nitehack/SFRNEC/Media/IMG-20140110-WA0000.jpg

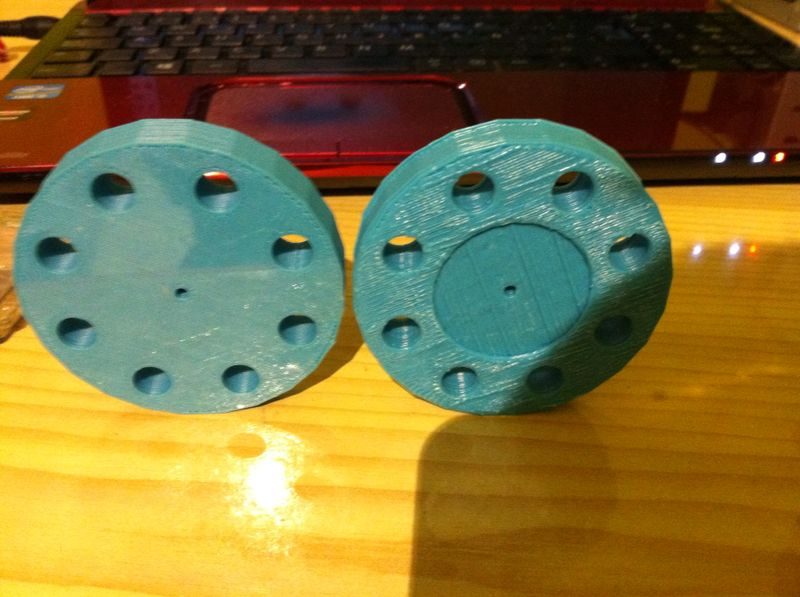
Media/IMG-20140110-WA0000.jpg
