nitehack/SFRNEC/Media/rueda libre.png

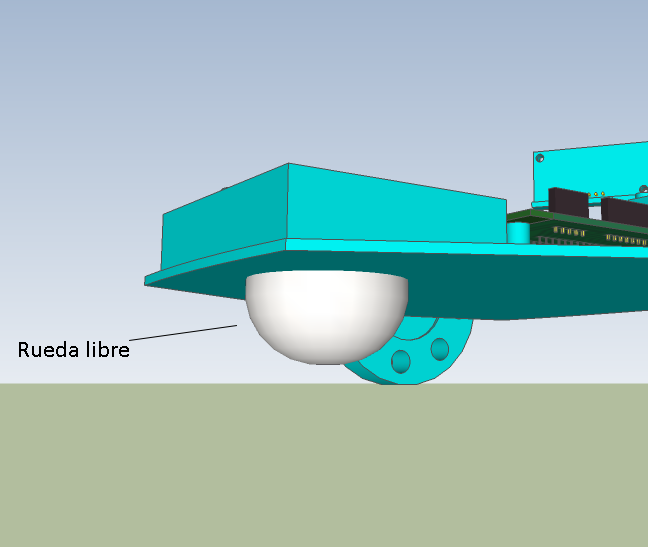
Media/rueda libre.png
