nitehack/SFRNEC/README.md

SFRNEC
======
This is a printable robot. 
It is a simple robot upgradeable. An example is included in the repository to control the robot via a IR remote control.

Authors
-------
Made for
* Víctor Burgos González
* Nicolás Guerrero García (Nitehack)
* Alejandro Toral López
* Pedro Manuel Vallejo Muñoz
