nitehack/SFRNEC/Hardware/Media/PCB 3D1.png

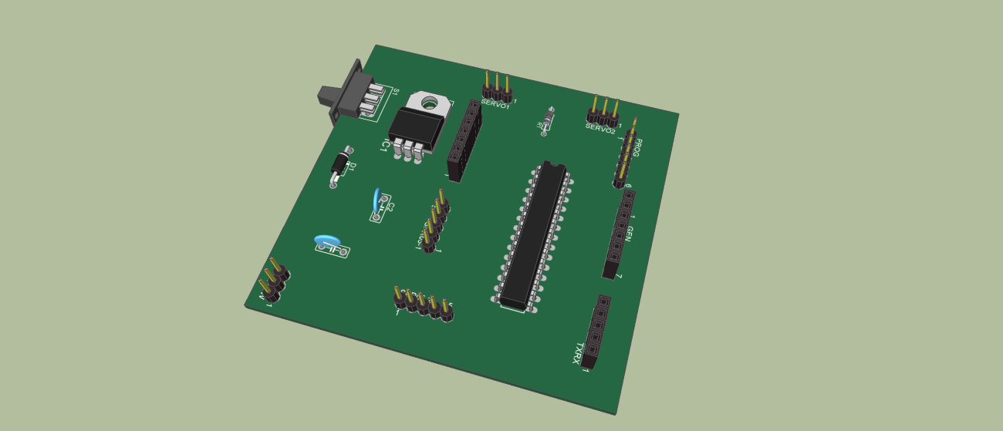
Hardware/Media/PCB 3D1.png
