nitehack/SFRNEC/Hardware/Media/PCB 3D.png

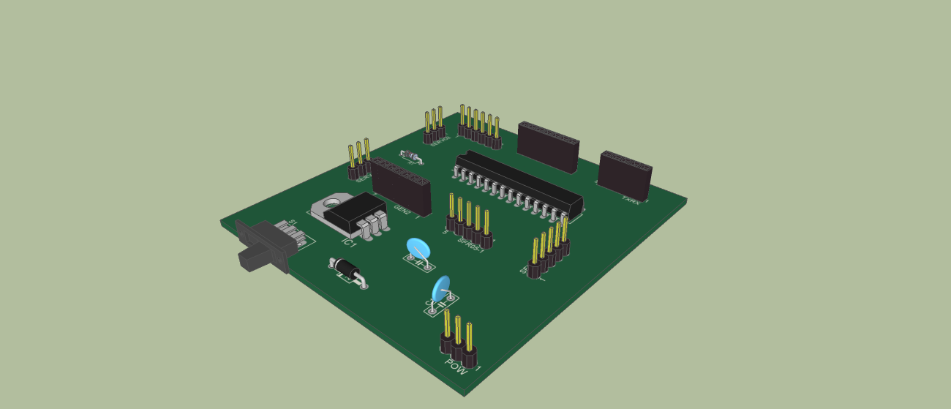
Hardware/Media/PCB 3D.png
