nitehack/SFRNEC/Hardware/PCB/pcb-bottom.png

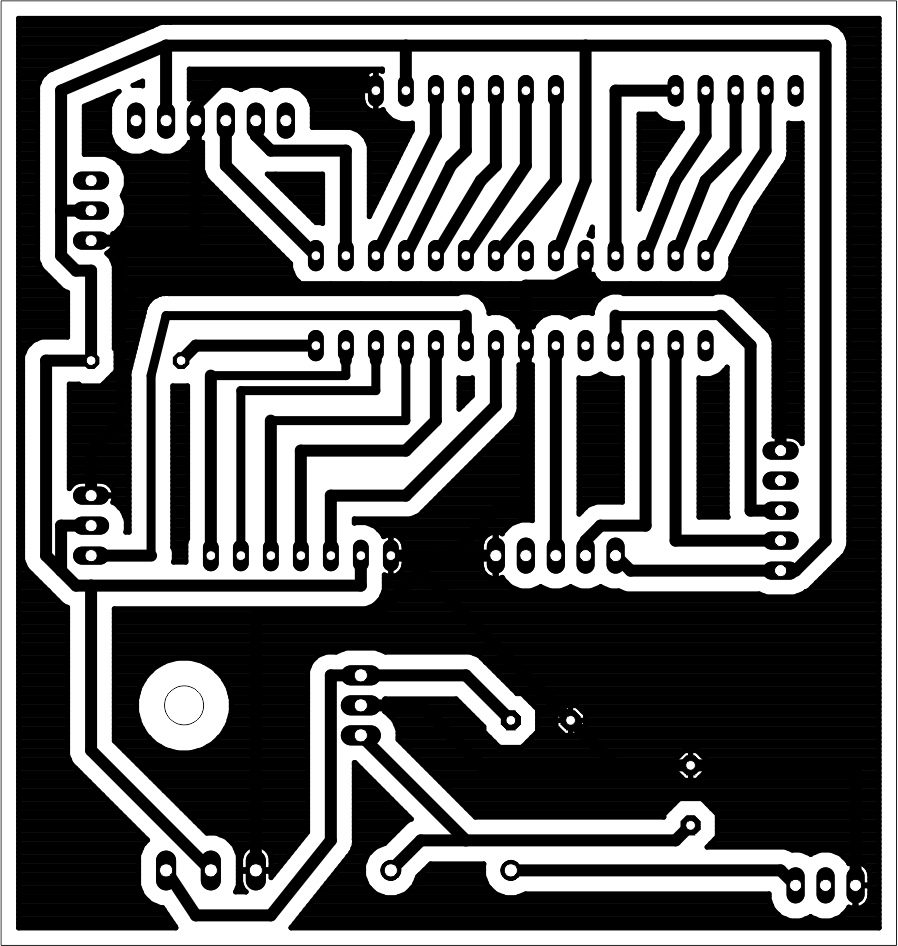
Hardware/PCB/pcb-bottom.png
