nitehack/SFRNEC/Hardware/PCB/pcb-top.png

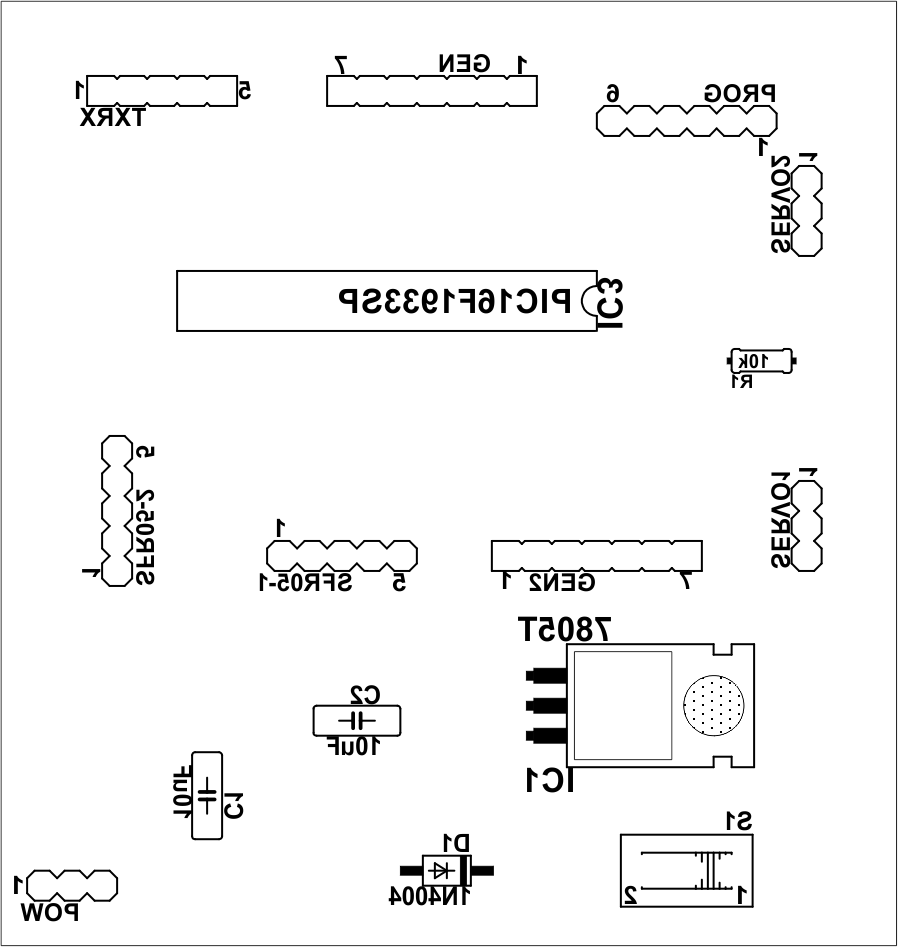
Hardware/PCB/pcb-top.png
