nitehack/SFRNEC/Media/descripcion base.png

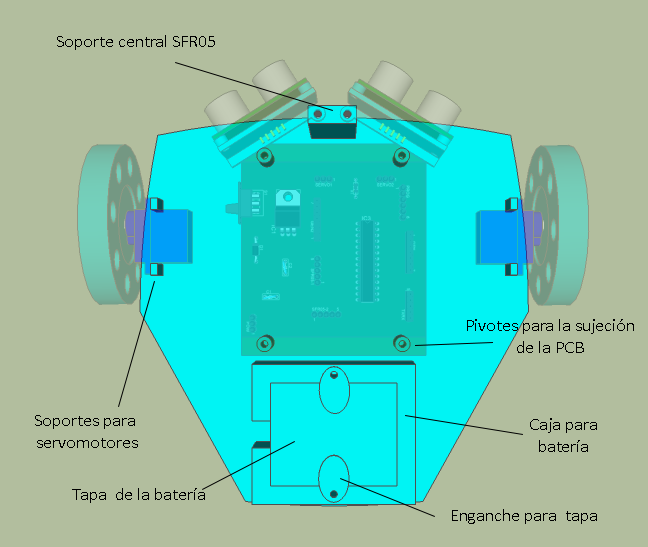
Media/descripcion base.png
