nitehack/SFRNEC/Media/IMG_2511.JPG

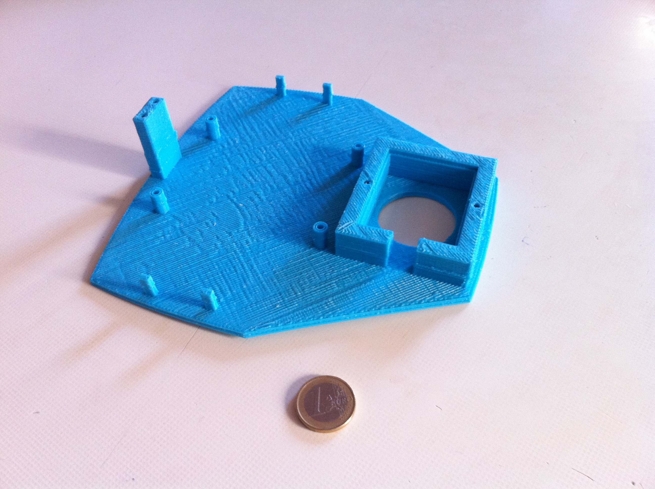
Media/IMG_2511.JPG
