nitehack/SFRNEC/Media/ruedas.png

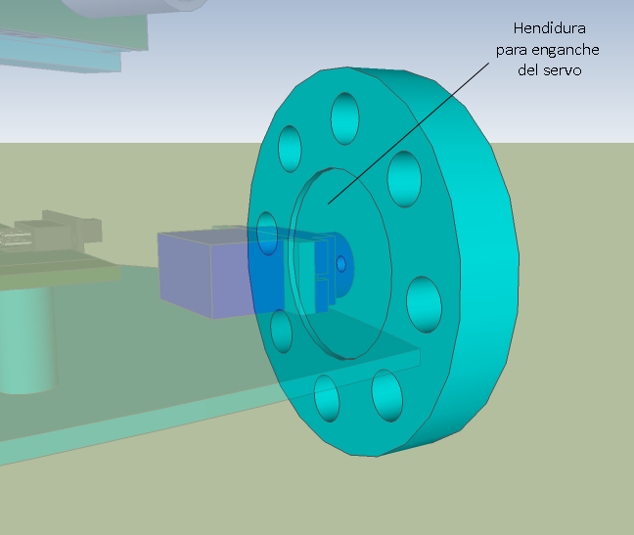
Media/ruedas.png
