nitehack/SFRNEC/Media/soporte sfr05.png

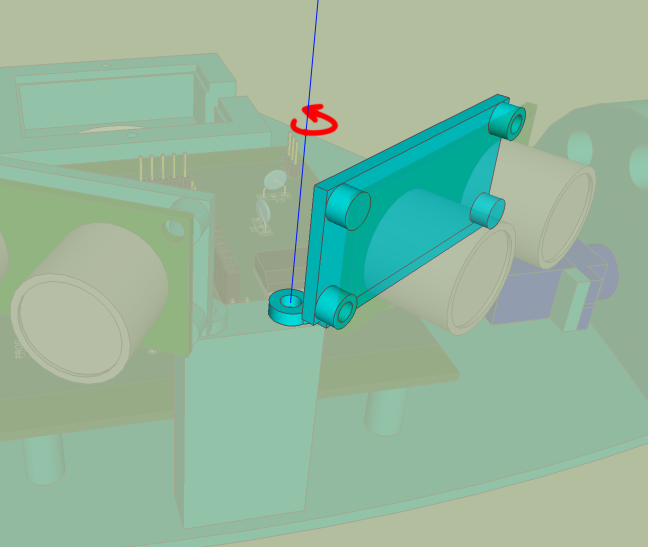
Media/soporte sfr05.png
