nitehack/SFRNEC/3D parts/3D printer/srf-hook.stl

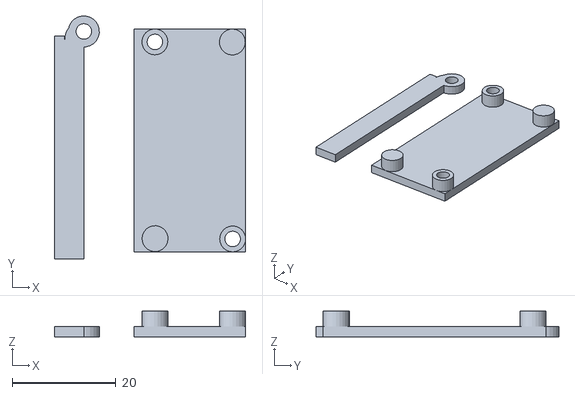
[picture p11: CAD file, 2014-02-22]
3D parts/3D printer/srf-hook.stl
36.9 x 46.9 x 5.00
