nitehack/SFRNEC/3D parts/3D printer/front.stl

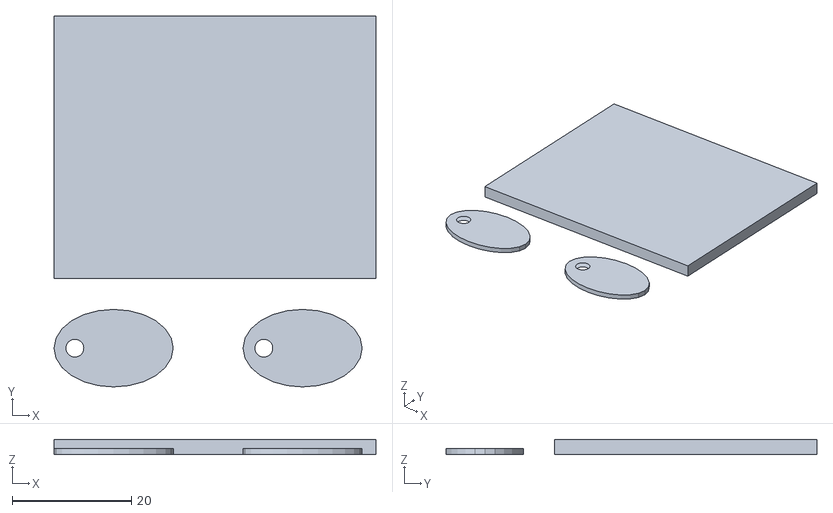
[picture p12: CAD file, 2014-02-22]
3D parts/3D printer/front.stl
54.0 x 62.2 x 2.50
