nitehack/SFRNEC/3D parts/3D printer/wheel.stl

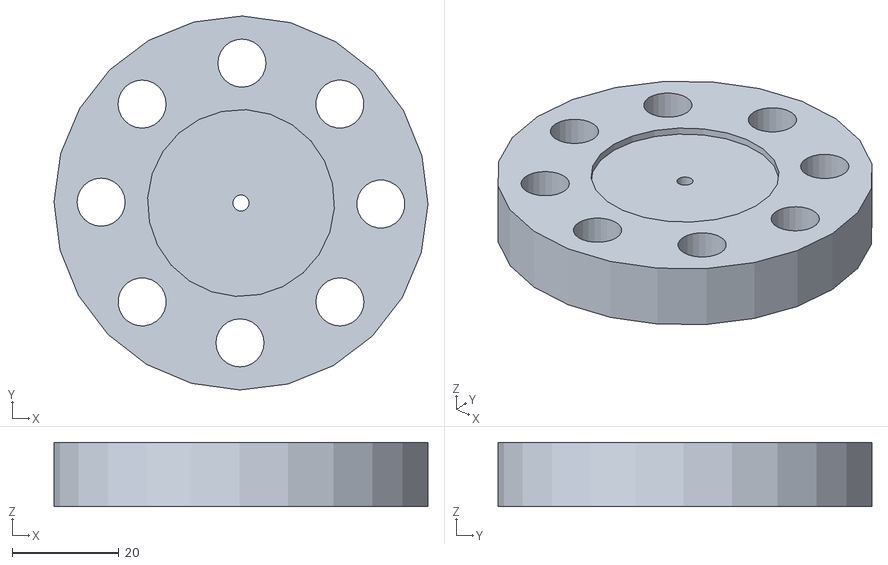
[picture p13: CAD file, 2014-02-22]
3D parts/3D printer/wheel.stl
70.0 x 70.0 x 12.0
