nitehack/SFRNEC/3D parts/3D printer/chassis.stl

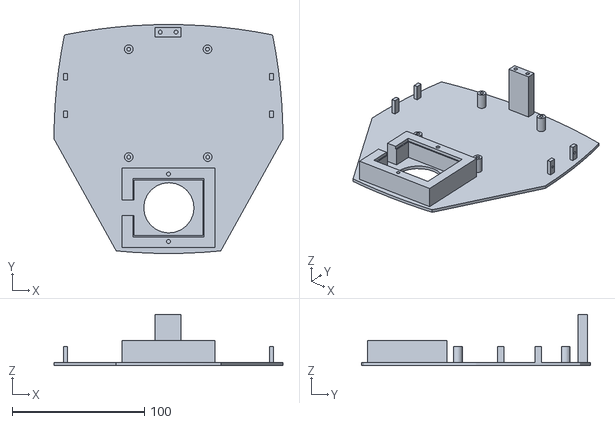
[picture p14: CAD file, 2014-02-22]
3D parts/3D printer/chassis.stl
173.2 x 173.2 x 38.9
