nitehack/SFRNEC/(list of files, cad)

Other CAD files:
3D parts/SRFNEC 3D/SRFNEC.skp
