nitehack/SFRNEC/Hardware/Schematics/schematic.pdf

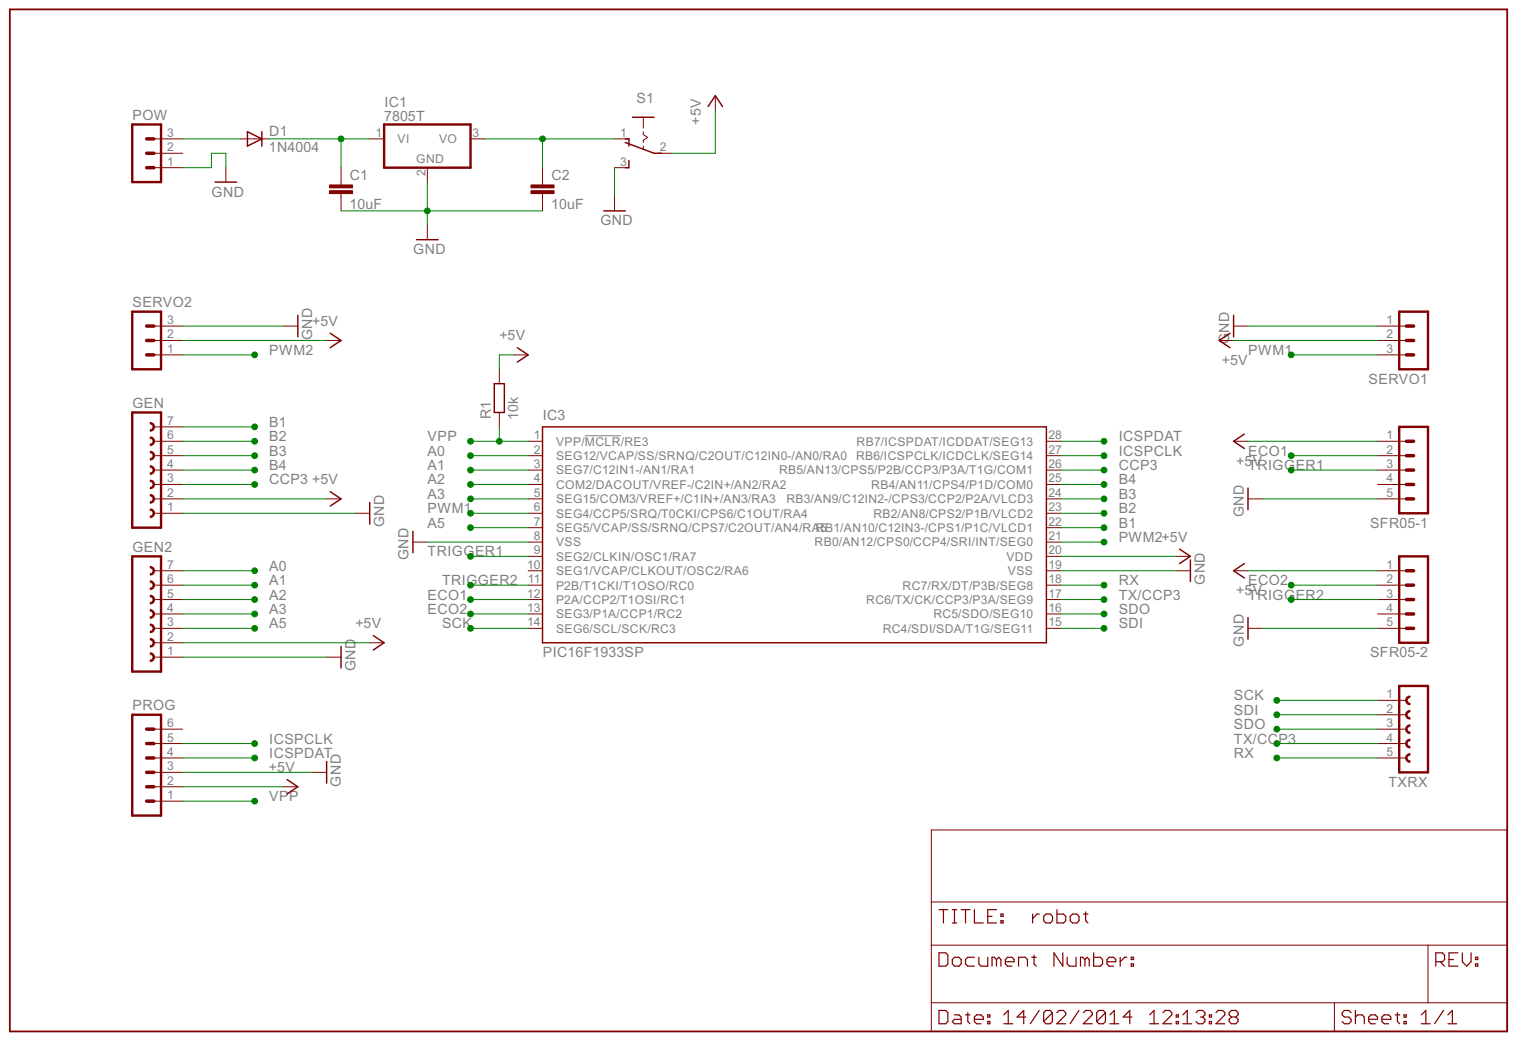
[picture p15: page 1]
