nitehack/SFRNEC/Hardware/Modules/IR Control/Modulo IR.pdf

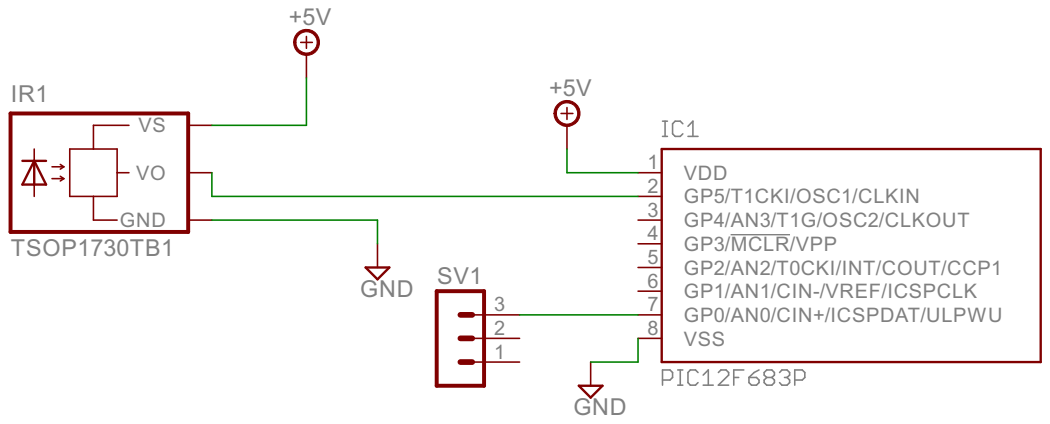
[picture p16: page 1]
