nitehack/SFRNEC/Hardware/Eagle/srfnec-pcb.brd

## EAGLE design Hardware/Eagle/srfnec-pcb.brd (2014-02-22)

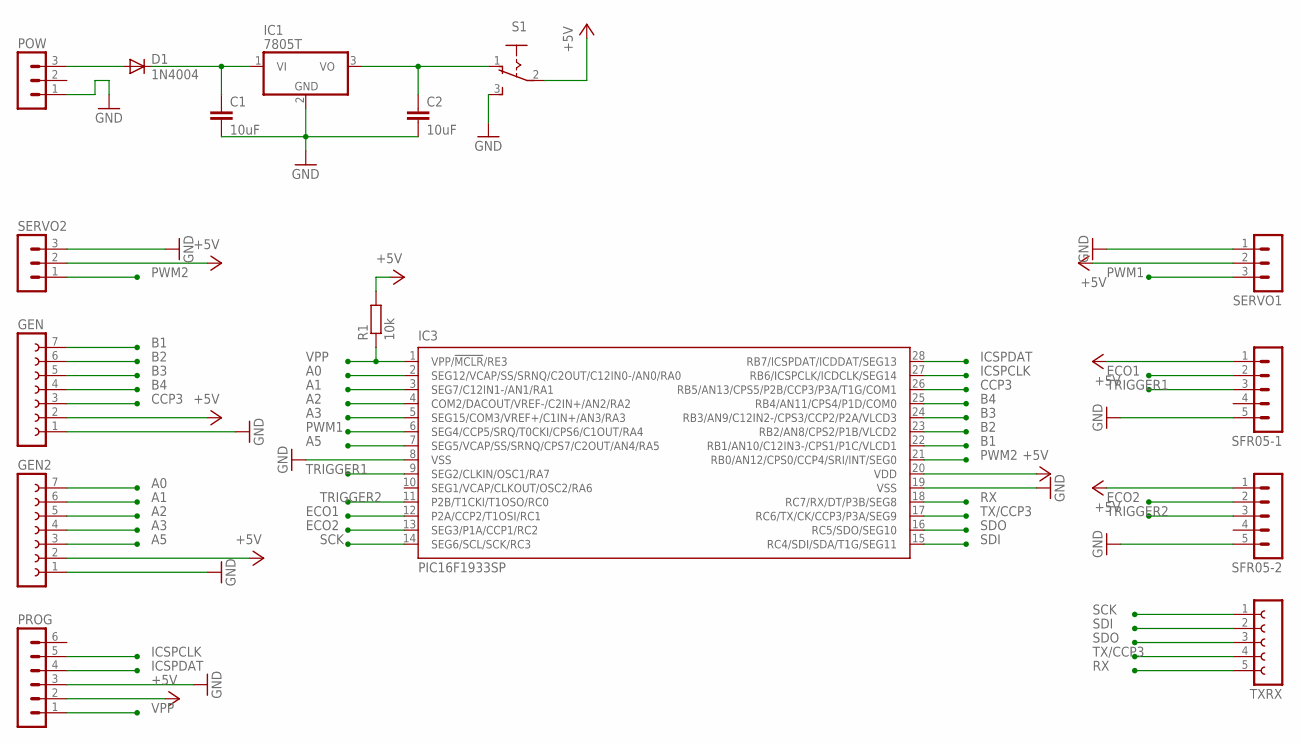
[picture p17: schematic srfnec-pcb.sch]

Parts:
C1, C2: 10uF; C5B2.5
D1: 1N4004; DO41-10
GEN, GEN2: FE07-1; FE07
IC1: 7805T; TO220H
IC3: PIC16F1933SP; DIL28-3
POW: MA03-1
PROG: MA06-1
R1: 10k; 0204/7
S1: 255SB
SERVO1, SERVO2: MA03-1
SFR05-1, SFR05-2: MA05-1
TXRX: FE05-1

Connections:
+5V: GEN.2, GEN2.2, IC3.20 (VDD), PROG.2, R1.2, S1.2, SERVO1.2, SERVO2.2, SFR05-1.1, SFR05-2.1
A0: GEN2.7, IC3.2 (SEG12/VCAP/SS/SRNQ/C2OUT/C12IN0-/AN0/RA0)
A1: GEN2.6, IC3.3 (SEG7/C12IN1-/AN1/RA1)
A2: GEN2.5, IC3.4 (COM2/DACOUT/VREF-/C2IN+/AN2/RA2)
A3: GEN2.4, IC3.5 (SEG15/COM3/VREF+/C1IN+/AN3/RA3)
A5: GEN2.3, IC3.7 (SEG5/VCAP/SS/SRNQ/CPS7/C2OUT/AN4/RA5)
B1: GEN.7, IC3.22 (RB1/AN10/C12IN3-/CPS1/P1C/VLCD1)
B2: GEN.6, IC3.23 (RB2/AN8/CPS2/P1B/VLCD2)
B3: GEN.5, IC3.24 (RB3/AN9/C12IN2-/CPS3/CCP2/P2A/VLCD3)
B4: GEN.4, IC3.25 (RB4/AN11/CPS4/P1D/COM0)
CCP3: GEN.3, IC3.26 (RB5/AN13/CPS5/P2B/CCP3/P3A/T1G/COM1)
ECO1: IC3.12 (P2A/CCP2/T1OSI/RC1), SFR05-1.2
ECO2: IC3.13 (SEG3/P1A/CCP1/RC2), SFR05-2.2
GND: C1.2, C2.2, GEN.1, GEN2.1, IC1.2 (GND), IC3.8 (VSS), IC3.19 (VSS), POW.1, PROG.3, S1.3 (S), SERVO1.1, SERVO2.3, SFR05-1.5, SFR05-2.5
ICSPCLK: IC3.27 (RB6/ICSPCLK/ICDCLK/SEG14), PROG.5
ICSPDAT: IC3.28 (RB7/ICSPDAT/ICDDAT/SEG13), PROG.4
unnamed: C1.1, D1.C, IC1.1 (VI)
unnamed: D1.A, POW.3
unnamed: C2.1, IC1.3 (VO), S1.1 (O)
PWM1: IC3.6 (SEG4/CCP5/SRQ/T0CKI/CPS6/C1OUT/RA4), SERVO1.3
PWM2: IC3.21 (RB0/AN12/CPS0/CCP4/SRI/INT/SEG0), SERVO2.1
RX: IC3.18 (RC7/RX/DT/P3B/SEG8), TXRX.5
SCK: IC3.14 (SEG6/SCL/SCK/RC3), TXRX.1
SDI: IC3.15 (RC4/SDI/SDA/T1G/SEG11), TXRX.2
SDO: IC3.16 (RC5/SDO/SEG10), TXRX.3
TRIGGER1: IC3.9 (SEG2/CLKIN/OSC1/RA7), SFR05-1.3
TRIGGER2: IC3.11 (P2B/T1CKI/T1OSO/RC0), SFR05-2.3
TX/CCP3: IC3.17 (RC6/TX/CK/CCP3/P3A/SEG9), TXRX.4
VPP: IC3.1 (VPP/!MCLR!/RE3), PROG.1, R1.1

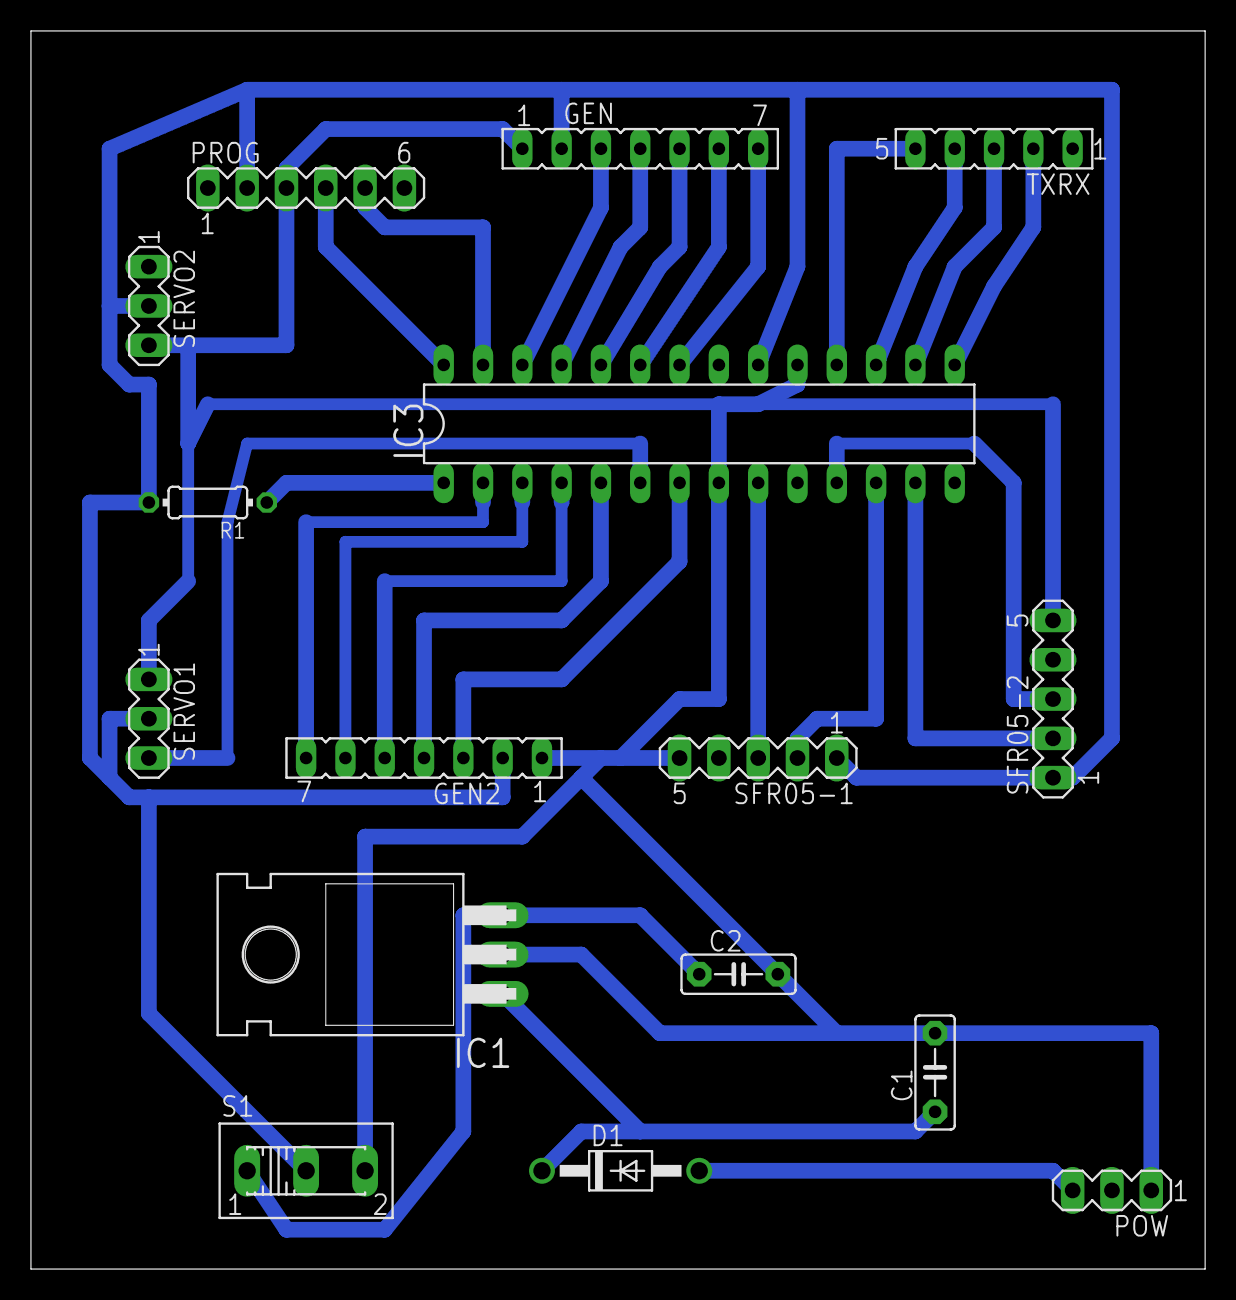
[picture p18: board srfnec-pcb.brd from above]

Board: 2 copper layers, 75.9 x 80.0 mm, 16 parts (0 on the bottom side), 29 nets.
